blindassassin111/Viktus_Minne_Plate_Files/README.md

# Viktus_Minne_Plate_Files
Plate files for the Viktus Minne keyboard

For Topre plates, you will need both the *.STEP and *.PDF files for manufacturing as the *.PDF contains the tapped hole and countersink information that the manu will need in order to accurately make the plates compatible.
