blindassassin111/Viktus_Minne_Plate_Files/Minne_Topre_Big_Bar_Plate.STEP

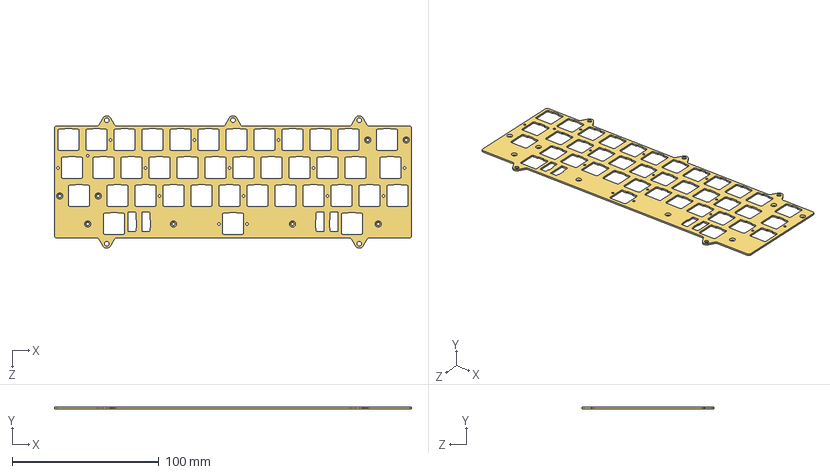
[picture p1: CAD file, 2023-04-09]
Minne_Topre_Big_Bar_Plate.STEP
242.9 x 1.20 x 90.1 mm
