blindassassin111/Viktus_Minne_Plate_Files/Minne_Big_Bar_Plate.STEP

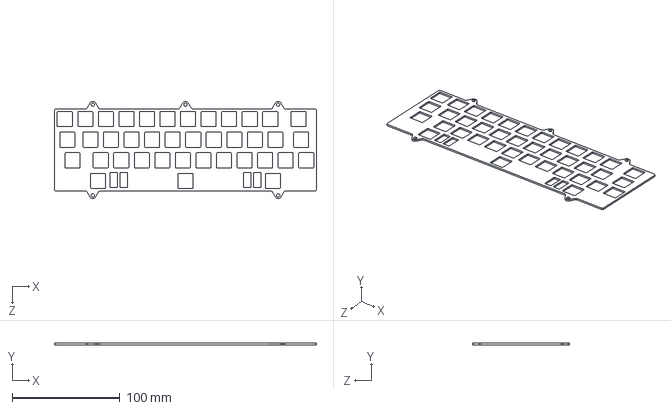
[picture p5: CAD file, 2023-01-08]
Minne_Big_Bar_Plate.STEP
242.9 x 1.50 x 90.1 mm
