blindassassin111/Viktus_Minne_Plate_Files/(list of files, cad)

Other CAD files:
Minne_Topre_Normal_Plate.STEP
Minne_6U_Plate.DXF
Minne_Big_Bar_Plate.DXF
Minne_Split_Plate.DXF
