blindassassin111/Viktus_Minne_Plate_Files/Minne_Topre_Big_Bar_Plate.PDF

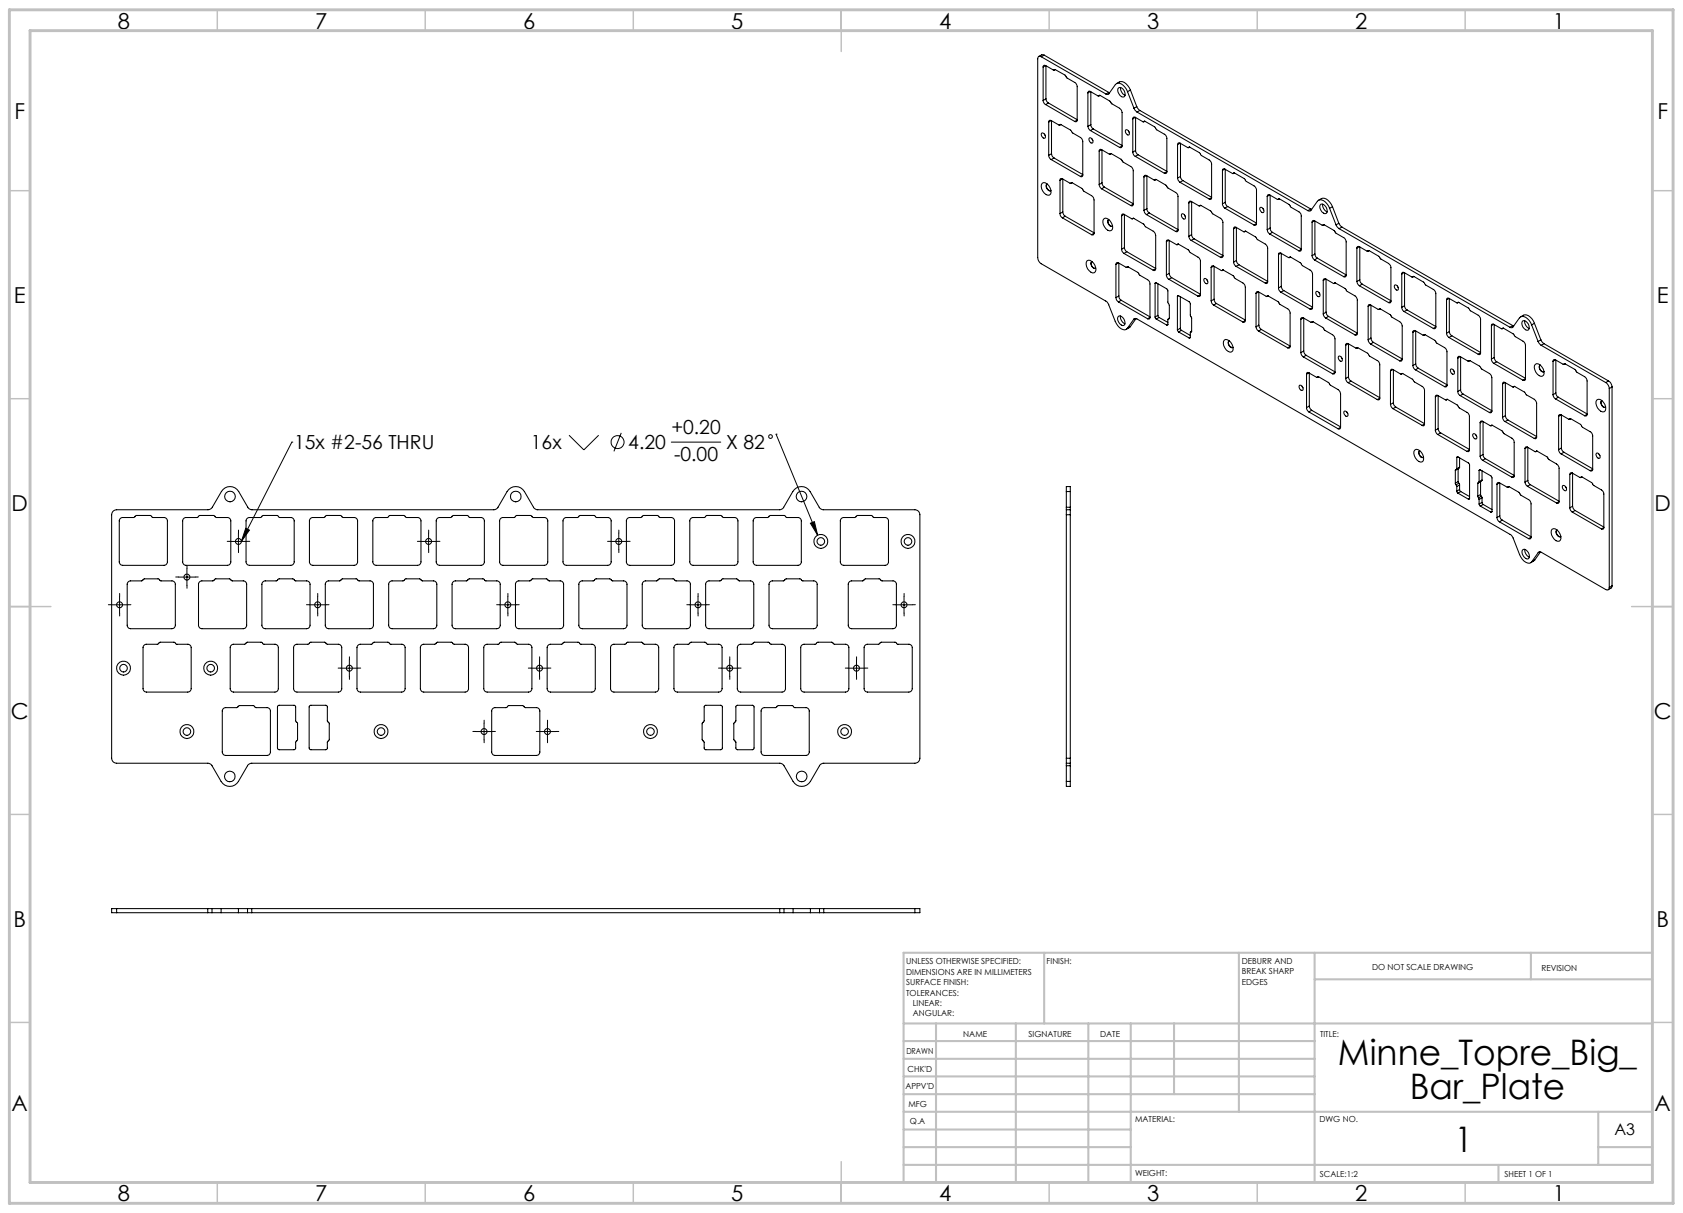
[picture p6: page 1]
15x #2-56 THRU; FINISH:; DEBURR AND; BREAK SHARP; DO NOT SCALE DRAWING; REVISION; SCALE:1:2; SHEET 1 OF 1

UNLESS OTHERWISE SPECIFIED:
DIMENSIONS ARE IN MILLIMETERS
SURFACE FINISH:
TOLERANCES:
LINEAR:
ANGULAR:

NAME | SIGNATURE | DATE | | | | TITLE: Minne_Topre_Big_ Bar_Plate

DRAWN
CHK'D
APPV'D
MFG
Q.A | | | | MATERIAL: | DWG NO. 1 | A3
